ruthgrace/mannys_sign/Node32 WS2812 Driver Schematic.pdf

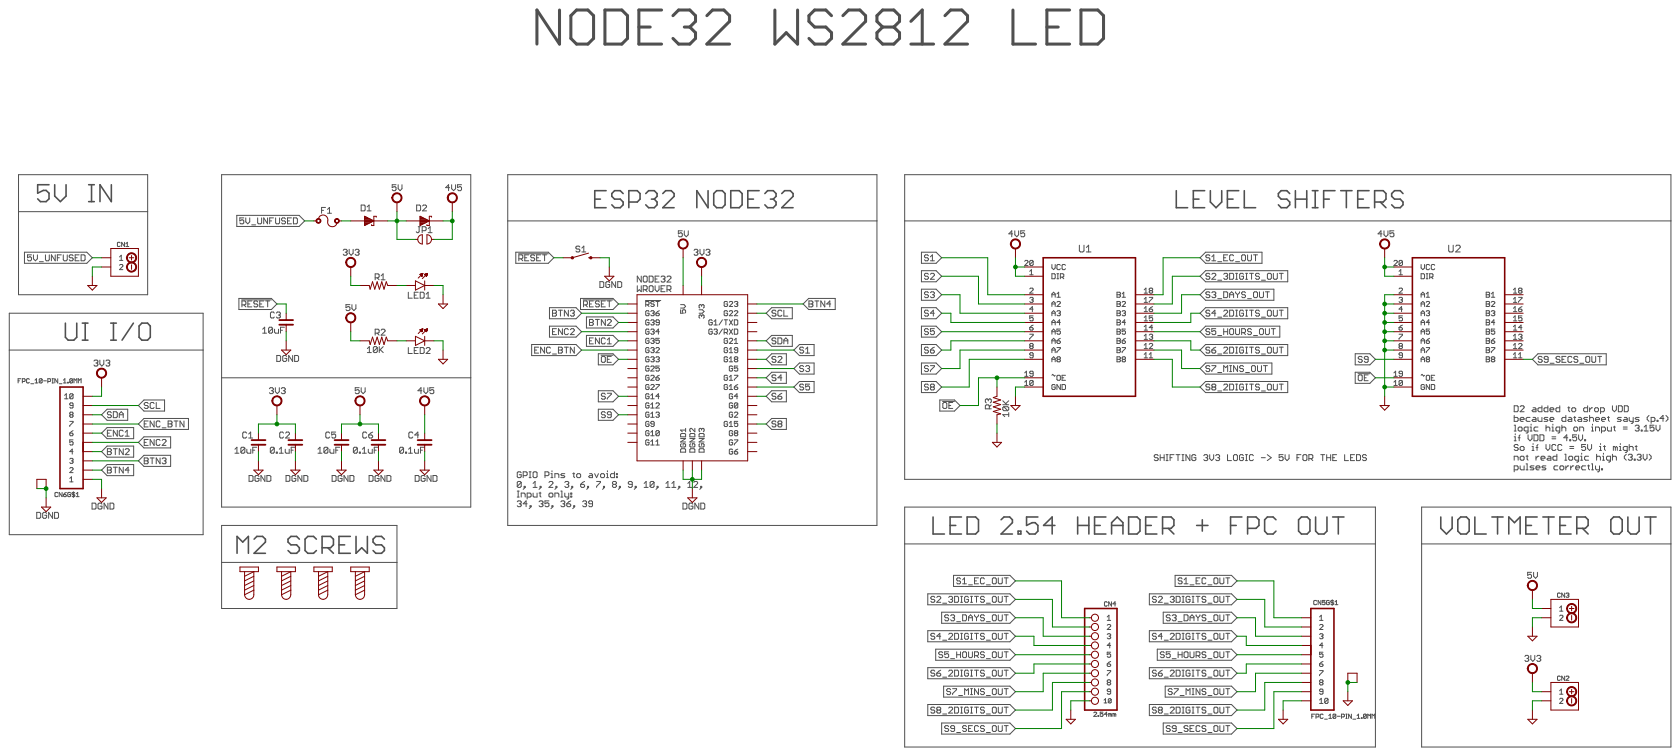
[picture p1: page 1]
