ruthgrace/mannys_sign/(commit log)

2019-10-31 Get both regions correct for hours sign
    [mannys_sign.ino]
2019-11-01 Add ESP32 specific stuff
    Anti-flicker!
2019-11-03 Two hours digits calibrated
2019-11-03 Hours digits calibrated
2019-11-03 Calibrate minute digits
2019-11-03 Calibrate and turn on labels
2019-11-03 Fix other things like hours on countdown
    [mannys_sign.ino]
2023-06-27 stuck on no type for TaskHandle_t
    [mannys_sign.ino]
2023-06-28 remove extra libraries - switching to platformio instead
2023-06-28 add breakout board to readme
2023-09-11 add led test code
2023-09-11 fix missing bracket
2023-12-15 change led color to red to test the digits
2023-12-15 red led test code for digits
2023-12-15 back to white led test code
2023-12-19 Update README.md
    distributing panels among power supplies
2023-12-21 update pin order for power supply distribution
2024-03-15 increase fade to black to fix lingering fade bug
    [mannys_sign.ino]
2024-03-16 update fadetoblackby increase to get rid of fade bug for minutes, hours, days as well
    [mannys_sign.ino]
